fenax/radio/Pi_Keyboard/Pi_Keyboard.kicad_pcb

## KiCad design Pi_Keyboard/Pi_Keyboard.kicad_pcb (2022-09-09)

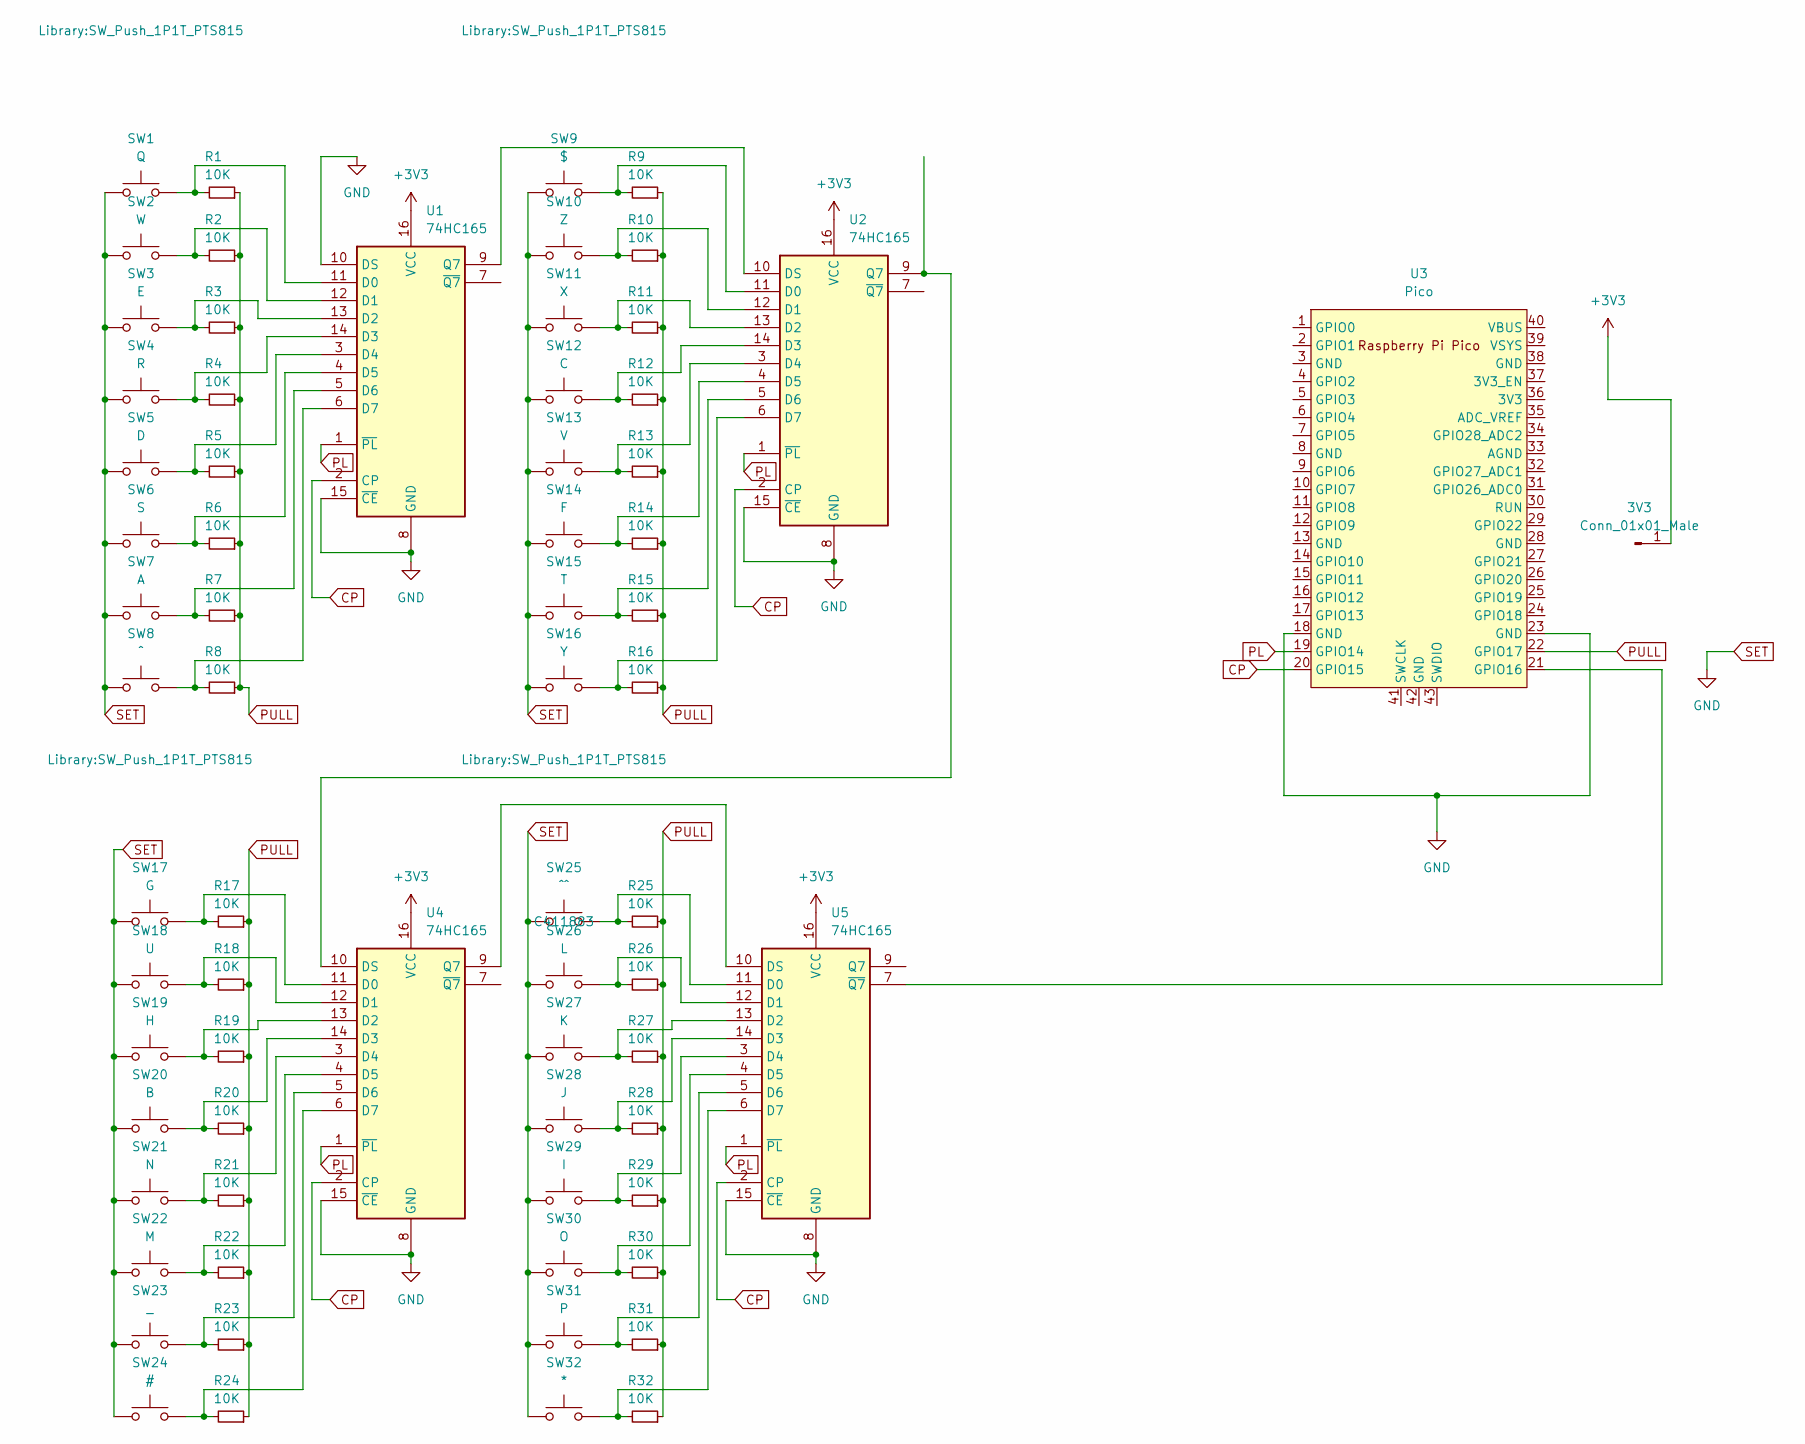
[picture p1: schematic Pi_Keyboard.kicad_sch]

Parts:
3V3: Conn_01x01_Male; PinHeader_1x01_P2.54mm_Vertical
R1, R2, R3, R4, R5, R6, R7, R8, R9, R10, R11, R12, R13, R14, R15, R16, R17, R18, R19, R20, R21, R22, R23, R24, R25, R26, R27, R28, R29, R30, R31, R32: 10K; R_0603_1608Metric
SW1: Q; SW_Push_1P1T_PTS815
SW2: W; SW_Push_1P1T_PTS815
SW3: E; SW_Push_1P1T_PTS815
SW4: R; SW_Push_1P1T_PTS815
SW5: D; SW_Push_1P1T_PTS815
SW6: S; SW_Push_1P1T_PTS815
SW7: A; SW_Push_1P1T_PTS815
SW8: ^; SW_Push_1P1T_PTS815
SW9: $; SW_Push_1P1T_PTS815
SW10: Z; SW_Push_1P1T_PTS815
SW11: X; SW_Push_1P1T_PTS815
SW12: C; SW_Push_1P1T_PTS815
SW13: V; SW_Push_1P1T_PTS815
SW14: F; SW_Push_1P1T_PTS815
SW15: T; SW_Push_1P1T_PTS815
SW16: Y; SW_Push_1P1T_PTS815
SW17: G; SW_Push_1P1T_PTS815
SW18: U; SW_Push_1P1T_PTS815
SW19: H; SW_Push_1P1T_PTS815
SW20: B; SW_Push_1P1T_PTS815
SW21: N; SW_Push_1P1T_PTS815
SW22: M; SW_Push_1P1T_PTS815
SW23: _; SW_Push_1P1T_PTS815
SW24: #; SW_Push_1P1T_PTS815
SW25: ^^; SW_Push_1P1T_PTS815; LCSC C411883
SW26: L; SW_Push_1P1T_PTS815
SW27: K; SW_Push_1P1T_PTS815
SW28: J; SW_Push_1P1T_PTS815
SW29: I; SW_Push_1P1T_PTS815
SW30: O; SW_Push_1P1T_PTS815
SW31: P; SW_Push_1P1T_PTS815
SW32: *; SW_Push_1P1T_PTS815
U1, U2, U4, U5: 74HC165; SOIC-16_3.9x9.9mm_P1.27mm
U3: Pico; RPi_Pico_SMD_TH

Connections:
+3V3: 3V3.1, U1.16 (VCC), U2.16 (VCC), U4.16 (VCC), U5.16 (VCC)
CP: U1.2 (CP), U2.2 (CP), U3.20 (GPIO15), U4.2 (CP), U5.2 (CP)
unnamed: R1.2, SW1.1, U1.11 (D0)
unnamed: R2.2, SW2.1, U1.12 (D1)
unnamed: R3.2, SW3.1, U1.13 (D2)
unnamed: R4.2, SW4.1, U1.14 (D3)
unnamed: R5.2, SW5.1, U1.3 (D4)
unnamed: R6.2, SW6.1, U1.4 (D5)
unnamed: R7.2, SW7.1, U1.5 (D6)
unnamed: R8.2, SW8.1, U1.6 (D7)
unnamed: R9.2, SW9.1, U2.11 (D0)
unnamed: R10.2, SW10.1, U2.12 (D1)
unnamed: R11.2, SW11.1, U2.13 (D2)
unnamed: R12.2, SW12.1, U2.14 (D3)
unnamed: R13.2, SW13.1, U2.3 (D4)
unnamed: R14.2, SW14.1, U2.4 (D5)
unnamed: R15.2, SW15.1, U2.5 (D6)
unnamed: R16.2, SW16.1, U2.6 (D7)
unnamed: R17.2, SW17.1, U4.11 (D0)
unnamed: R18.2, SW18.1, U4.12 (D1)
unnamed: R19.2, SW19.1, U4.13 (D2)
unnamed: R20.2, SW20.1, U4.14 (D3)
unnamed: R21.2, SW21.1, U4.3 (D4)
unnamed: R22.2, SW22.1, U4.4 (D5)
unnamed: R23.2, SW23.1, U4.5 (D6)
unnamed: R24.2, SW24.1, U4.6 (D7)
unnamed: R25.2, SW25.1, U5.11 (D0)
unnamed: R26.2, SW26.1, U5.12 (D1)
unnamed: R27.2, SW27.1, U5.13 (D2)
unnamed: R28.2, SW28.1, U5.14 (D3)
unnamed: R29.2, SW29.1, U5.3 (D4)
unnamed: R30.2, SW30.1, U5.4 (D5)
unnamed: R31.2, SW31.1, U5.5 (D6)
unnamed: R32.2, SW32.1, U5.6 (D7)
unnamed: U1.9 (Q7), U2.10 (DS)
unnamed: U2.9 (Q7), U4.10 (DS)
unnamed: U3.21 (GPIO16), U5.7 (~Q7)
unnamed: U4.9 (Q7), U5.10 (DS)
PL: U1.1 (~PL), U2.1 (~PL), U3.19 (GPIO14), U4.1 (~PL), U5.1 (~PL)
PULL: R1.1, R2.1, R3.1, R4.1, R5.1, R6.1, R7.1, R8.1, R9.1, R10.1, R11.1, R12.1, R13.1, R14.1, R15.1, R16.1, R17.1, R18.1, R19.1, R20.1, R21.1, R22.1, R23.1, R24.1, R25.1, R26.1, R27.1, R28.1, R29.1, R30.1, R31.1, R32.1, U3.22 (GPIO17)
SET: SW1.2, SW2.2, SW3.2, SW4.2, SW5.2, SW6.2, SW7.2, SW8.2, SW9.2, SW10.2, SW11.2, SW12.2, SW13.2, SW14.2, SW15.2, SW16.2, SW17.2, SW18.2, SW19.2, SW20.2, SW21.2, SW22.2, SW23.2, SW24.2, SW25.2, SW26.2, SW27.2, SW28.2, SW29.2, SW30.2, SW31.2, SW32.2, U1.8 (GND), U1.10 (DS), U1.15 (~CE), U2.8 (GND), U2.15 (~CE), U3.18 (GND), U3.23 (GND), U4.8 (GND), U4.15 (~CE), U5.8 (GND), U5.15 (~CE)

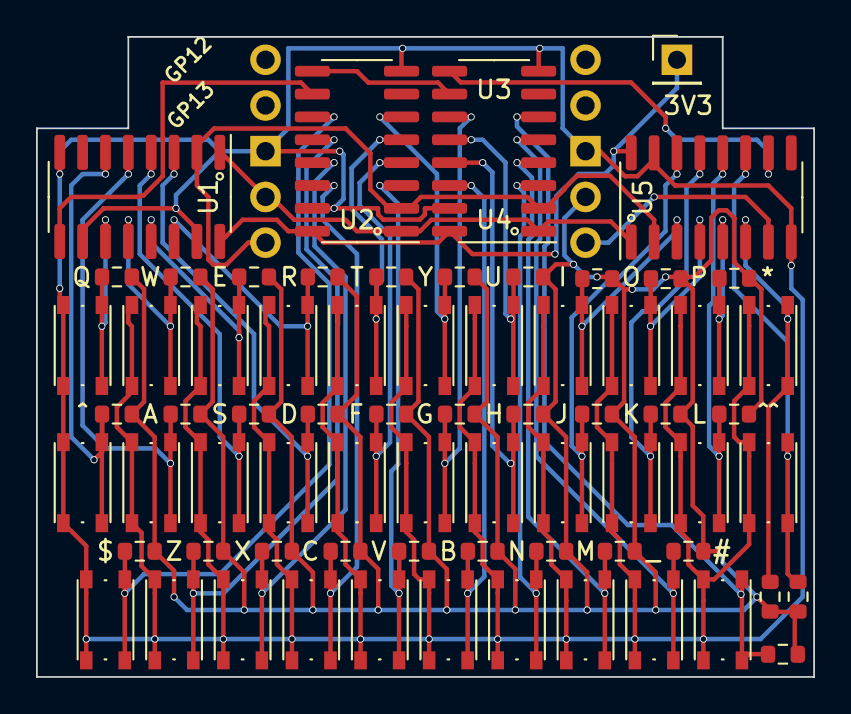
[picture p2: board Pi_Keyboard.kicad_pcb from above]

Board: 2 copper layers, 43.2 x 35.6 mm, 70 parts (0 on the bottom side), 41 nets.
