fenax/radio/LoRa_thing/LoRa_thing.kicad_pcb

## KiCad design LoRa_thing/LoRa_thing.kicad_pcb (2022-09-06)

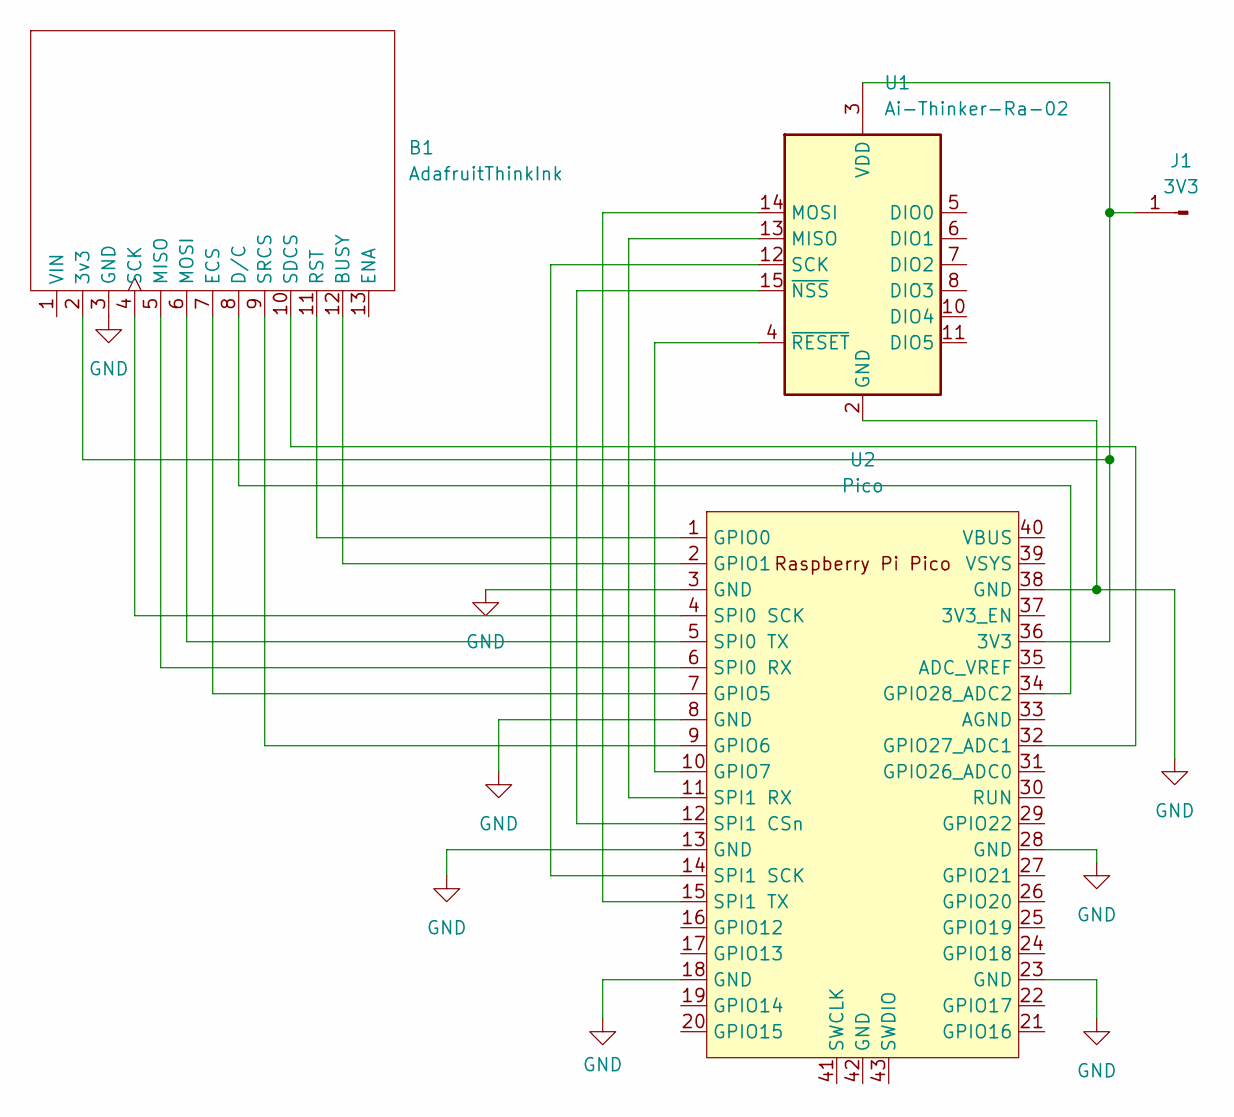
[picture p3: schematic LoRa_thing.kicad_sch]

Parts:
B1: AdafruitThinkInk; Adafruit ThinkInk Tricolor 200
J1: 3V3; PinHeader_1x01_P2.54mm_Vertical
U1: Ai-Thinker-Ra-02; DIP-16_RA_02
U2: Pico; RPi_Pico_SMD_TH

Connections:
GND: B1.3 (GND), U1.1 (GND), U1.2 (GND), U1.9 (GND), U1.16 (GND), U2.3 (GND), U2.8 (GND), U2.13 (GND), U2.18 (GND), U2.23 (GND), U2.28 (GND), U2.38 (GND)
unnamed: B1.2 (3v3), J1.1, U1.3 (VDD), U2.36 (3V3)
unnamed: B1.4 (SCK), U2.4 (SPI0 SCK)
unnamed: B1.5 (MISO), U2.6 (SPI0 RX)
unnamed: B1.6 (MOSI), U2.5 (SPI0 TX)
unnamed: B1.7 (ECS), U2.7 (GPIO5)
unnamed: B1.8 (D/C), U2.34 (GPIO28_ADC2)
unnamed: B1.9 (SRCS), U2.9 (GPIO6)
unnamed: B1.10 (SDCS), U2.32 (GPIO27_ADC1)
unnamed: B1.11 (RST), U2.1 (GPIO0)
unnamed: B1.12 (BUSY), U2.2 (GPIO1)
unnamed: U1.4 (~RESET), U2.10 (GPIO7)
unnamed: U1.12 (SCK), U2.14 (SPI1 SCK)
unnamed: U1.13 (MISO), U2.11 (SPI1 RX)
unnamed: U1.14 (MOSI), U2.15 (SPI1 TX)
unnamed: U1.15 (~NSS), U2.12 (SPI1 CSn)

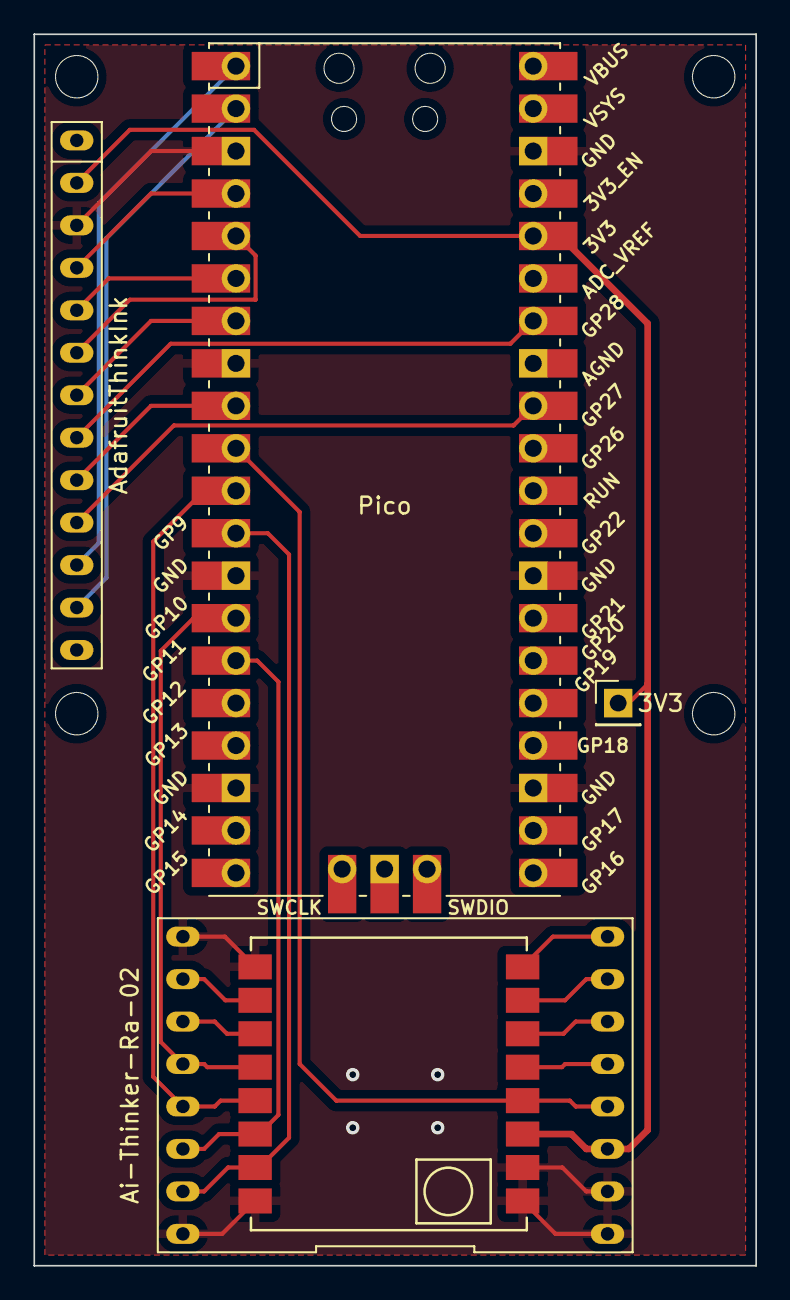
[picture p4: board LoRa_thing.kicad_pcb from above]

Board: 2 copper layers, 43.2 x 73.7 mm, 4 parts (0 on the bottom side), 16 nets.
